olvt-avionics/Switch-PCB/Assem2.STEP

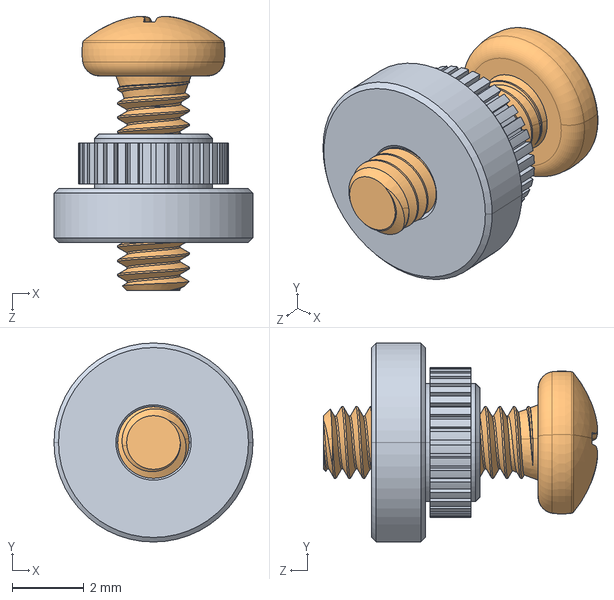
[picture p1: CAD file, 2023-10-09]
Assem2.STEP
5.56 x 5.56 x 7.66 mm
94100A150_18-8 Stainless Steel Press-Fit Nut for Soft Metal and Plastic_94100A150
92000A013_Passivated 18-8 Stainless Steel Pan Head Phillips Screws_92000A013
