olvt-avionics/Switch-PCB/TE/440054-2.step

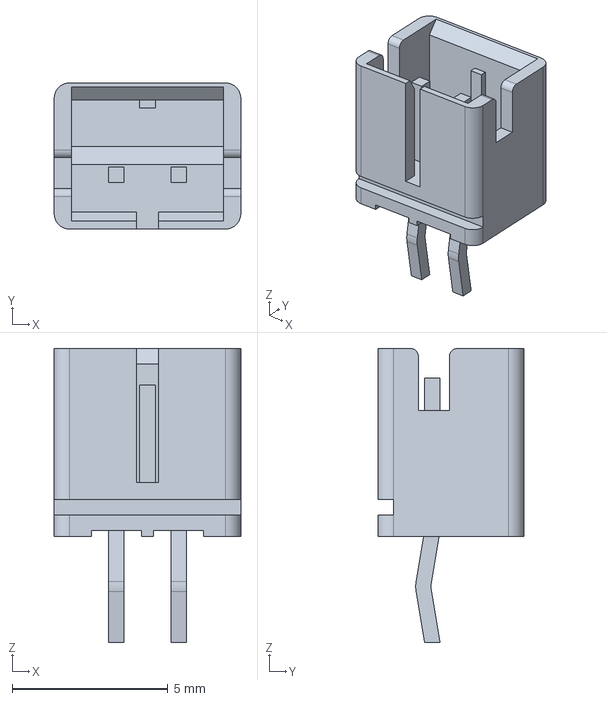
[picture p2: CAD file, 2023-10-09]
TE/440054-2.step
6.00 x 4.70 x 9.45 mm
