olvt-avionics/Switch-PCB/(list of files, cad)

Other CAD files:
Assem1.STEP
