olvt-avionics/Switch-PCB/switches.kicad_pcb

## KiCad design switches.kicad_pcb (2023-10-09)

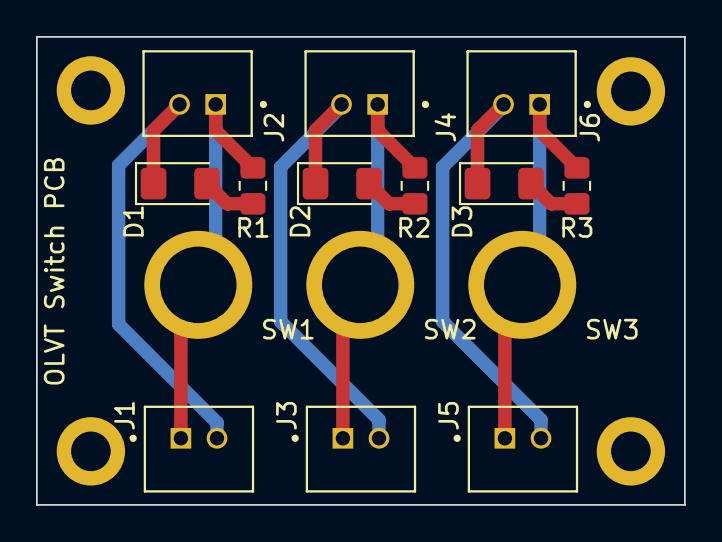
[picture p3: board switches.kicad_pcb from above]

Board: 2 copper layers, 36.0 x 26.0 mm, 15 parts (0 on the bottom side), 9 nets.

Parts:
D1, D2, D3: LED; LED_1206_3216Metric_Pad1.42x1.75mm_HandSolder
J1, J2, J3, J4, J5, J6: 440054-2; TE_440054-2
R1, R2, R3: 360; R_0805_2012Metric_Pad1.20x1.40mm_HandSolder
SW1, SW2, SW3: SW_Screw; screw switch

Connections:
unnamed: D1.1 (K), J1.2, J2.2
unnamed: D1.2 (A), R1.2
unnamed: D2.1 (K), J3.2, J4.2
unnamed: D2.2 (A), R2.2
unnamed: D3.1 (K), J5.2, J6.2
unnamed: D3.2 (A), R3.2
unnamed: J2.1, R1.1
unnamed: J4.1, R2.1
unnamed: J6.1, R3.1
